PhamTheMy3089/Ardu_ECU/REFERENCES/Hardware/3D Printable Files/Bendix Sleeve.stl

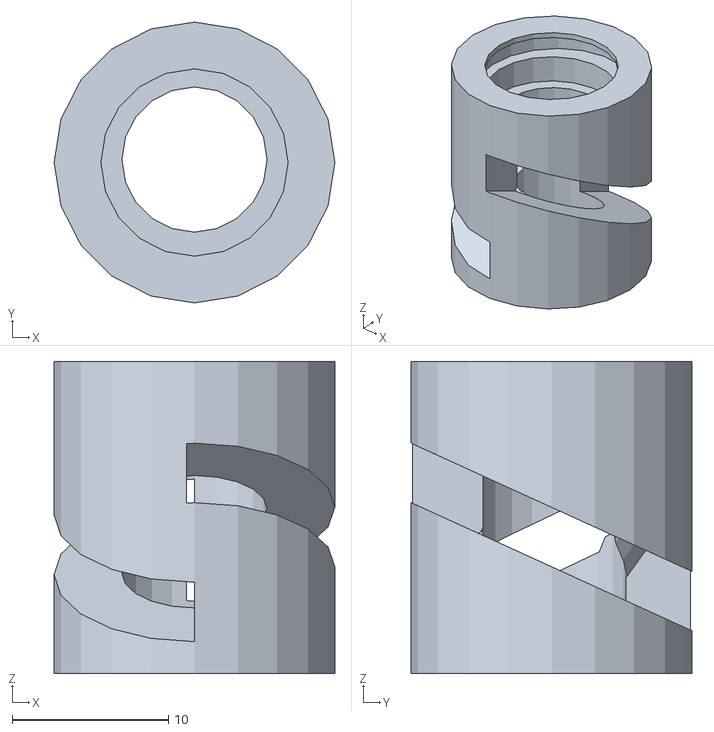
[picture p6: CAD file, 2026-07-16]
REFERENCES/Hardware/3D Printable Files/Bendix Sleeve.stl
18.0 x 18.0 x 20.0
