PhamTheMy3089/Ardu_ECU/REFERENCES/Hardware/3D Printable Files/Brushless motor mount.stl

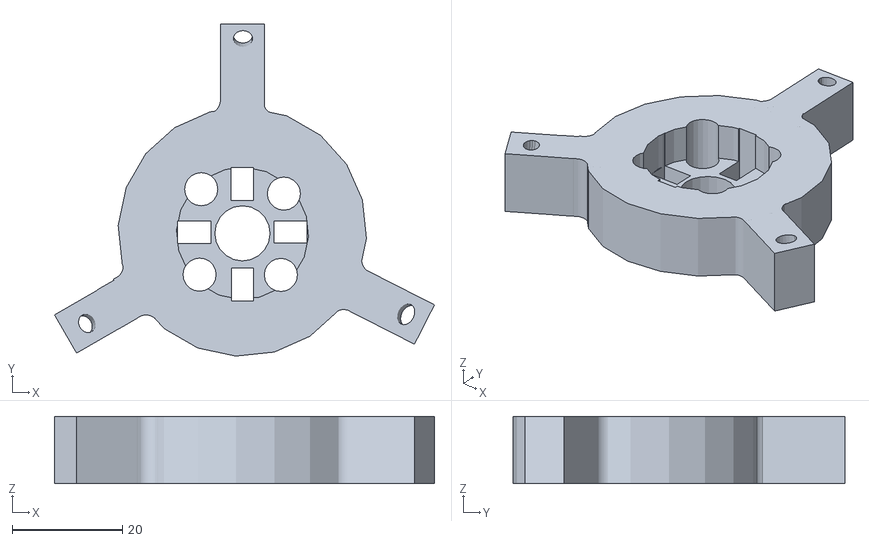
[picture p7: CAD file, 2026-07-16]
REFERENCES/Hardware/3D Printable Files/Brushless motor mount.stl
68.9 x 60.2 x 12.2
