PhamTheMy3089/Ardu_ECU/PROJECT_CURRENT/Docs/BringUp_Logs/RPM_TEST_STARTER_log_20260719.txt

# Log bench-test cảm biến RPM bằng firmware TEST_STARTER (2026-07-19)
#
# Bối cảnh: chạy sau khi đã sửa lỗi D1 (TVS clamp sai kẹp GPIO33 xuống ~2V).
# Rotor được thổi quay bằng gió (starter chưa kéo tải thật), tốc độ rất chậm.
# Quét PWM 1000 -> 1220us, ppr=1, filter=120us, edge=RISING, step=10us.
#
# Kết luận đọc log:
#  - Xung RPM ĐÃ tới GPIO33 (raw=1..5/cửa sổ 100ms) -> sửa D1 thành công.
#  - RPM ghim ~1500 và NOISE nhảy CLEAN<->NOISY, cv/jit vọt cao là artifact
#    lượng tử hóa ở tốc độ quay rất thấp (chỉ ~3 xung/cửa sổ), KHÔNG phải lỗi.
#  - REST_GUARD đúng: khi OFF và PWM thấp -> RPM=0 / NO_SIGNAL.
#  - Sau STARTER OFF, RPM=1500 treo vài cửa sổ do rotor quay trớn -> bình thường.
# ------------------------------------------------------------------------------

TEST_STARTER booted. Starter DISARMED at 1000us (khong quay).
Dung '+' / '-' de tang/giam PWM. Go 'help' de xem menu.
Web UI: SSID=TEST_STARTER PASS=test1234 URL=http://192.168.4.1

==== TEST_STARTER: RPM vs PWM noise/stability ====
  +           tang PWM starter 1 buoc
  -           giam PWM starter 1 buoc
  0 / s       dung starter (PWM=1000us)
  step <us>   doi buoc +/- (1..200)
  pwm <us>    dat PWM truc tiep (1000..2000)
  ppr <n>     xung/vong (mac dinh 1)
  filter <us> bo loc glitch RPM (20..2000)
  edge rising|falling   canh kich RPM
  reset       xoa bo dem RPM
  status      in trang thai ngay
  help        in menu nay
  hien tai: step=10us ppr=1 filter=120us edge=RISING
==================================================

ESC armed. San sang test.
PWM=1000us(OFF) | RPM=83 (win 223) | raw=10 acc=9 rej=0 (0.0%) | jit=390.0% cv=-- | NOISE=NOISY STAB=OFF
PWM=1000us(OFF) | RPM=83 (win 0) | raw=0 acc=0 rej=0 (0.0%) | jit=0.0% cv=0.0% | NOISE=CLEAN STAB=OFF
PWM=1000us(OFF) | RPM=0 (win 0) | raw=0 acc=0 rej=0 (0.0%) | jit=0.0% cv=0.0% | NOISE=NO_SIGNAL STAB=OFF
PWM=1000us(OFF) | RPM=0 (win 0) | raw=0 acc=0 rej=0 (0.0%) | jit=0.0% cv=0.0% | NOISE=NO_SIGNAL STAB=OFF
PWM=1000us(OFF) | RPM=0 (win 0) | raw=0 acc=0 rej=0 (0.0%) | jit=0.0% cv=0.0% | NOISE=NO_SIGNAL STAB=OFF
PWM=1000us(OFF) | RPM=0 (win 0) | raw=0 acc=0 rej=0 (0.0%) | jit=0.0% cv=0.0% | NOISE=NO_SIGNAL STAB=OFF
PWM=1000us(OFF) | RPM=0 (win 0) | raw=0 acc=0 rej=0 (0.0%) | jit=0.0% cv=0.0% | NOISE=NO_SIGNAL STAB=OFF
PWM=1000us(OFF) | RPM=0 (win 0) | raw=0 acc=0 rej=0 (0.0%) | jit=0.0% cv=0.0% | NOISE=NO_SIGNAL STAB=OFF
PWM=1010us (+)
PWM=1010us | RPM=0 (win 0) | raw=0 acc=0 rej=0 (0.0%) | jit=0.0% cv=-- | NOISE=NO_SIGNAL STAB=SETTLING
PWM=1010us | RPM=0 (win 0) | raw=0 acc=0 rej=0 (0.0%) | jit=0.0% cv=-- | NOISE=NO_SIGNAL STAB=SETTLING
PWM=1020us (+)
PWM=1020us | RPM=0 (win 0) | raw=0 acc=0 rej=0 (0.0%) | jit=0.0% cv=-- | NOISE=NO_SIGNAL STAB=SETTLING
PWM=1030us (+)
PWM=1030us | RPM=0 (win 0) | raw=0 acc=0 rej=0 (0.0%) | jit=0.0% cv=-- | NOISE=NO_SIGNAL STAB=SETTLING
PWM=1040us (+)
PWM=1040us | RPM=0 (win 0) | raw=0 acc=0 rej=0 (0.0%) | jit=0.0% cv=-- | NOISE=NO_SIGNAL STAB=SETTLING
PWM=1050us (+)
PWM=1050us | RPM=0 (win 0) | raw=0 acc=0 rej=0 (0.0%) | jit=0.0% cv=-- | NOISE=NO_SIGNAL STAB=SETTLING
PWM=1060us (+)
PWM=1060us | RPM=0 (win 0) | raw=0 acc=0 rej=0 (0.0%) | jit=0.0% cv=-- | NOISE=NO_SIGNAL STAB=SETTLING
PWM=1060us | RPM=0 (win 0) | raw=0 acc=0 rej=0 (0.0%) | jit=0.0% cv=-- | NOISE=NO_SIGNAL STAB=SETTLING
PWM=1070us (+)
PWM=1070us | RPM=0 (win 0) | raw=0 acc=0 rej=0 (0.0%) | jit=0.0% cv=-- | NOISE=NO_SIGNAL STAB=SETTLING
PWM=1080us (+)
PWM=1080us | RPM=0 (win 0) | raw=0 acc=0 rej=0 (0.0%) | jit=0.0% cv=-- | NOISE=NO_SIGNAL STAB=SETTLING
PWM=1090us (+)
PWM=1090us | RPM=0 (win 0) | raw=0 acc=0 rej=0 (0.0%) | jit=0.0% cv=-- | NOISE=NO_SIGNAL STAB=SETTLING
PWM=1090us | RPM=0 (win 0) | raw=0 acc=0 rej=0 (0.0%) | jit=0.0% cv=-- | NOISE=NO_SIGNAL STAB=SETTLING
PWM=1100us (+)
PWM=1100us | RPM=0 (win 0) | raw=0 acc=0 rej=0 (0.0%) | jit=0.0% cv=-- | NOISE=NO_SIGNAL STAB=SETTLING
PWM=1110us (+)
PWM=1110us | RPM=0 (win 0) | raw=0 acc=0 rej=0 (0.0%) | jit=0.0% cv=-- | NOISE=NO_SIGNAL STAB=SETTLING
PWM=1110us | RPM=0 (win 0) | raw=0 acc=0 rej=0 (0.0%) | jit=0.0% cv=-- | NOISE=NO_SIGNAL STAB=SETTLING
PWM=1120us (+)
PWM=1120us | RPM=0 (win 0) | raw=0 acc=0 rej=0 (0.0%) | jit=0.0% cv=-- | NOISE=NO_SIGNAL STAB=SETTLING
PWM=1130us (+)
PWM=1130us | RPM=0 (win 0) | raw=0 acc=0 rej=0 (0.0%) | jit=0.0% cv=-- | NOISE=NO_SIGNAL STAB=SETTLING
PWM=1140us (+)
PWM=1140us | RPM=0 (win 0) | raw=0 acc=0 rej=0 (0.0%) | jit=0.0% cv=-- | NOISE=NO_SIGNAL STAB=SETTLING
PWM=1140us | RPM=0 (win 0) | raw=0 acc=0 rej=0 (0.0%) | jit=0.0% cv=-- | NOISE=NO_SIGNAL STAB=SETTLING
PWM=1140us | RPM=0 (win 0) | raw=0 acc=0 rej=0 (0.0%) | jit=0.0% cv=-- | NOISE=NO_SIGNAL STAB=SETTLING
PWM=1140us | RPM=0 (win 0) | raw=0 acc=0 rej=0 (0.0%) | jit=0.0% cv=-- | NOISE=NO_SIGNAL STAB=NO_SIGNAL
PWM=1140us | RPM=0 (win 0) | raw=0 acc=0 rej=0 (0.0%) | jit=0.0% cv=-- | NOISE=NO_SIGNAL STAB=NO_SIGNAL
PWM=1150us (+)
PWM=1150us | RPM=4 (win 0) | raw=0 acc=0 rej=0 (0.0%) | jit=0.0% cv=-- | NOISE=CLEAN STAB=SETTLING
PWM=1150us | RPM=100 (win 0) | raw=0 acc=0 rej=0 (0.0%) | jit=0.0% cv=139.0% | NOISE=CLEAN STAB=SETTLING
PWM=1160us (+)
PWM=1160us | RPM=250 (win 500) | raw=1 acc=1 rej=0 (0.0%) | jit=0.0% cv=39.1% | NOISE=CLEAN STAB=SETTLING
PWM=1160us | RPM=500 (win 500) | raw=1 acc=1 rej=0 (0.0%) | jit=0.0% cv=51.2% | NOISE=CLEAN STAB=SETTLING
PWM=1160us | RPM=500 (win 500) | raw=1 acc=1 rej=0 (0.0%) | jit=0.0% cv=46.9% | NOISE=CLEAN STAB=SETTLING
PWM=1160us | RPM=500 (win 500) | raw=1 acc=1 rej=0 (0.0%) | jit=0.0% cv=38.6% | NOISE=CLEAN STAB=UNSTABLE
PWM=1170us (+)
PWM=1170us | RPM=750 (win 750) | raw=2 acc=2 rej=0 (0.0%) | jit=40.0% cv=-- | NOISE=WARN STAB=SETTLING
PWM=1170us | RPM=750 (win 1000) | raw=2 acc=2 rej=0 (0.0%) | jit=0.0% cv=14.3% | NOISE=CLEAN STAB=SETTLING
PWM=1170us | RPM=1500 (win 1000) | raw=2 acc=2 rej=0 (0.0%) | jit=66.7% cv=37.8% | NOISE=NOISY STAB=SETTLING
PWM=1170us | RPM=1479 (win 1000) | raw=2 acc=2 rej=0 (0.0%) | jit=65.4% cv=37.7% | NOISE=NOISY STAB=UNSTABLE
PWM=1170us | RPM=750 (win 1000) | raw=2 acc=2 rej=0 (0.0%) | jit=0.0% cv=34.4% | NOISE=CLEAN STAB=UNSTABLE
PWM=1180us (+)
PWM=1180us | RPM=1500 (win 1500) | raw=3 acc=3 rej=0 (0.0%) | jit=0.0% cv=34.6% | NOISE=CLEAN STAB=SETTLING
PWM=1180us | RPM=1500 (win 1000) | raw=2 acc=2 rej=0 (0.0%) | jit=66.7% cv=28.3% | NOISE=NOISY STAB=SETTLING
PWM=1190us (+)
PWM=1190us | RPM=1500 (win 1500) | raw=3 acc=3 rej=0 (0.0%) | jit=0.0% cv=-- | NOISE=CLEAN STAB=SETTLING
PWM=1190us | RPM=1500 (win 1500) | raw=3 acc=3 rej=0 (0.0%) | jit=0.0% cv=0.0% | NOISE=CLEAN STAB=SETTLING
PWM=1190us | RPM=1500 (win 1500) | raw=3 acc=3 rej=0 (0.0%) | jit=0.0% cv=0.0% | NOISE=CLEAN STAB=SETTLING
PWM=1200us (+)
PWM=1200us | RPM=1500 (win 1500) | raw=3 acc=3 rej=0 (0.0%) | jit=0.0% cv=-- | NOISE=CLEAN STAB=SETTLING
PWM=1200us | RPM=1500 (win 1500) | raw=3 acc=3 rej=0 (0.0%) | jit=0.0% cv=0.0% | NOISE=CLEAN STAB=SETTLING
PWM=1200us | RPM=1500 (win 1500) | raw=3 acc=3 rej=0 (0.0%) | jit=0.0% cv=0.0% | NOISE=CLEAN STAB=SETTLING
PWM=1200us | RPM=1500 (win 1500) | raw=3 acc=3 rej=0 (0.0%) | jit=0.0% cv=0.0% | NOISE=CLEAN STAB=STABLE
PWM=1200us | RPM=1500 (win 2000) | raw=4 acc=4 rej=0 (0.0%) | jit=131.7% cv=0.0% | NOISE=NOISY STAB=STABLE
PWM=1210us (+)
PWM=1210us | RPM=1500 (win 1875) | raw=5 acc=5 rej=0 (0.0%) | jit=124.1% cv=-- | NOISE=NOISY STAB=SETTLING
PWM=1210us | RPM=1500 (win 1500) | raw=3 acc=3 rej=0 (0.0%) | jit=0.0% cv=0.0% | NOISE=CLEAN STAB=SETTLING
PWM=1210us | RPM=1500 (win 1500) | raw=3 acc=3 rej=0 (0.0%) | jit=0.0% cv=0.3% | NOISE=CLEAN STAB=SETTLING
PWM=1210us | RPM=94488 (win 2000) | raw=4 acc=4 rej=0 (0.0%) | jit=130.5% cv=294.0% | NOISE=NOISY STAB=UNSTABLE
PWM=1210us | RPM=1500 (win 1500) | raw=3 acc=3 rej=0 (0.0%) | jit=0.0% cv=307.8% | NOISE=CLEAN STAB=UNSTABLE
PWM=1210us | RPM=1500 (win 1500) | raw=3 acc=3 rej=0 (0.0%) | jit=0.0% cv=307.8% | NOISE=CLEAN STAB=UNSTABLE
PWM=1210us | RPM=1500 (win 1500) | raw=3 acc=3 rej=0 (0.0%) | jit=0.0% cv=307.8% | NOISE=CLEAN STAB=UNSTABLE
PWM=1220us (+)
PWM=1220us | RPM=1500 (win 1500) | raw=3 acc=3 rej=0 (0.0%) | jit=0.0% cv=-- | NOISE=CLEAN STAB=SETTLING
PWM=1220us | RPM=1500 (win 1500) | raw=3 acc=3 rej=0 (0.0%) | jit=0.0% cv=0.0% | NOISE=CLEAN STAB=SETTLING
PWM=1220us | RPM=1500 (win 1500) | raw=3 acc=3 rej=0 (0.0%) | jit=0.0% cv=0.0% | NOISE=CLEAN STAB=SETTLING
PWM=1220us | RPM=1500 (win 1500) | raw=3 acc=3 rej=0 (0.0%) | jit=0.0% cv=0.0% | NOISE=CLEAN STAB=STABLE
PWM=1220us | RPM=1500 (win 1500) | raw=3 acc=3 rej=0 (0.0%) | jit=0.0% cv=0.0% | NOISE=CLEAN STAB=STABLE
PWM=1220us | RPM=1500 (win 2000) | raw=4 acc=4 rej=0 (0.0%) | jit=131.9% cv=0.0% | NOISE=NOISY STAB=STABLE
STARTER OFF (PWM=1000us).
PWM=1000us(OFF) | RPM=1500 (win 1500) | raw=3 acc=3 rej=0 (0.0%) | jit=0.0% cv=0.0% | NOISE=CLEAN STAB=OFF
PWM=1000us(OFF) | RPM=1500 (win 1500) | raw=3 acc=3 rej=0 (0.0%) | jit=0.0% cv=0.0% | NOISE=CLEAN STAB=OFF
PWM=1000us(OFF) | RPM=1500 (win 1500) | raw=3 acc=3 rej=0 (0.0%) | jit=0.0% cv=0.0% | NOISE=CLEAN STAB=OFF
PWM=1000us(OFF) | RPM=1500 (win 1500) | raw=3 acc=3 rej=0 (0.0%) | jit=1.4% cv=315.1% | NOISE=CLEAN STAB=OFF
PWM=1000us(OFF) | RPM=1500 (win 1500) | raw=3 acc=3 rej=0 (0.0%) | jit=0.0% cv=315.1% | NOISE=CLEAN STAB=OFF
