PhamTheMy3089/Ardu_ECU/(list of files, drawings)

Other design files:
PROJECT_CURRENT/Hardware/SCH_MinijetengineECU_20260723.json
