PhamTheMy3089/Ardu_ECU/(commit log)

2026-07-16 Add reference folder with system documentation and current state files
    - Create "Tham khảo" (Reference) folder
    - Add RPM_Sensor_20260709.net - RPM sensor schematic
    - Add ECU_TestV1_EGT_DRY_START_PATCH.ino - Test firmware version
    - Add SCH_MinijetengineECU_20260709.json - ECU design schema
    Claude-Session: https://claude.ai/code/session_01CcruVnyNiUwatgB1FCaWjr
    [SCH_MinijetengineECU_20260709.json]
2026-07-16 Reorganize project structure for better organization and maintainability
    Changes:
    - Create Documentation/ folder for guides and manuals
    * Documentation/Manuals/ for all user guides
    - Create Hardware/ folder for all hardware-related files
    * Hardware/Schematics/ - Circuit diagrams and reference schemas
    * Hardware/Components/ - Component images and references
    * Hardware/3D Printable Files/ - 3D models for printing
    - Create Firmware/ folder with version-based organization
    * Firmware/Rev9/, Rev10/ - Archived versions
    * Firmware/Rev11/ - Current stable release
    * Firmware/Rev12_TC10/ - Test version
    * Firmware/TestV1_EGT_DRY_START/ - Latest development
    - Eliminate duplicate firmware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
    [Bendix Sleeve.stl, Brushed motor mount.stl, Brushless motor mount.stl, SCH_MinijetengineECU_20260709.json]
2026-07-16 Add comprehensive project review and assessment
    - Analysis of project structure, organization, and file arrangement
    - Firmware version comparison (Rev11, Rev12_TC10, TestV1_EGT_DRY_START)
    - Code quality assessment with strengths and issues
    - Documentation completeness review
    - 10 key recommendations with priorities
    - Security and performance analysis
    - Improvement checklist for future development
    - Overall project scoring (7.5/10 - Grade B+)
    Focus areas for improvement:
    - Add hardware assembly and pinout documentation
    - Create component BOM with suppliers
    - Add comprehensive code comments
    - Implement CI/CD pipeline
    - Create testing procedures
    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
2026-07-16 Reorganize project structure: separate CURRENT project from REFERENCES
    Major Changes:
    - Create PROJECT_CURRENT/ folder for active project (3 files)
    * ECU_TestV1_EGT_DRY_START_PATCH.ino (main firmware)
    * RPM_Sensor_20260709.net (RPM sensor schematic)
    * SCH_MinijetengineECU_20260709.json (ECU design schema)
    - Move all reference materials to REFERENCES/ folder
    * REFERENCES/Firmware/ (Rev9, Rev10, Rev11, Rev12_TC10, TestV1)
    * REFERENCES/Hardware/ (schematics, 3D models, components)
    * REFERENCES/Documentation/ (old manuals and guides)
    Documentation:
    - Add PROJECT_CURRENT/README.md (current project guide)
    - Add REFERENCES/README.md (reference materials guide)
    - Update main README.md (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
    [Bendix Sleeve.stl, Brushed motor mount.stl, Brushless motor mount.stl, SCH_MinijetengineECU_20260709.json]
2026-07-16 Add comprehensive firmware code architecture guide
    - Detailed explanation of state machine design
    - Configuration structure and parameters
    - EGT, RPM, and fuel control systems
    - Pin assignments and connections
    - Start sequence flow
    - Web UI and SD logging systems
    - Test Wizard/Checklist integration
    - Safety features and abort mechanisms
    - Debugging tips and learning path
    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
2026-07-16 Add comprehensive firmware upload and testing guide
    Content includes:
    - Hardware requirements checklist
    - Arduino IDE setup (Board Manager, Libraries)
    - ESP32 board configuration
    - Pin connections and wiring diagram
    - Step-by-step firmware upload process
    - Serial Monitor testing (115200 baud)
    - Web UI access and testing (ECU_TestV1 / admin1234)
    - Detailed test procedures:
    * Power & Serial communication
    * Status LED behavior
    * EGT sensor reading & validation
    * RPM sensor signal quality
    * Button input testing
    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
2026-07-16 Add code review findings, pre-engine test guide, and reference documents
    - CODE_REVIEW_FINDINGS.md: Full firmware review (8 findings: 2 HIGH, 3 MEDIUM, 3 LOW)
    - HIGH: stage2Off() missing EGT guard for Web UI path
    - HIGH: ABORTED restart requires no fault acknowledgment
    - MEDIUM: First RPM pulse after resetRpmStats() bypasses glitch filter
    - MEDIUM: stale egt.gradientCps displayed when sensor invalid
    - MEDIUM: Serial readStringUntil can block loop up to 1s
    - PRE_ENGINE_TEST_GUIDE.md: Step-by-step noise check and test procedure
    - Phase 0: Physical inspection checklist
    - Phase 1: First boot verification
    - Phase 2: RPM noise characterization (REST_GUARD, EMI from glow/starter)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
2026-07-16 Fix all 8 code review findings in ECU firmware
    Bug fixes applied to ECU_TestV1_EGT_DRY_START_PATCH.ino:
    HIGH:
    - Fix #1: stage2Off() now blocks transition to WAITING when in ABORTED
    mode and EGT is still hot (was missing EGT guard for Serial/Web UI path)
    - Fix #2: Restart from ABORTED now requires explicit clearabort command;
    abortAcknowledged flag is reset on every abortAll() and must be set
    before arm2/startidle; physical button sets flag automatically
    MEDIUM:
    - Fix #3: RPM ISR no longer counts first pulse after resetRpmStats() as
    accepted — records timestamp only, preventing EMI spike at start of
    wet ST_SPINUP_PREHEAT from masking starter failure
    - Fix #3b: resetRpmStats() is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
    [ECU_TestV1_EGT_DRY_START_PATCH.ino]
2026-07-16 Add TEST/TEST_STARTER bench firmware for RPM vs starter PWM testing
    Standalone test sketch to characterize the RPM sensor and starter before
    running the real engine. No ARM, no protection interlocks — focused purely
    on RPM noise and stability measurement per PWM level.
    Behavior:
    - On boot, starter stays disarmed at 1000us (does not spin)
    - '+' / '-' keys step starter PWM up/down (default 10us step, adjustable)
    - ESP32 continuously measures RPM and reports two verdicts:
    * NOISE: CLEAN / WARN / NOISY / NO_SIGNAL (from rejectPct + jitter)
    * STAB: STABLE / WARN / UNSTABLE / SETTLING / OFF (from RPM CV% once PWM settles)
    - Reuses the same glitch filter and ISR logic as the main ECU firmwa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
    [TEST_STARTER.ino]
2026-07-16 Add DSO152 RPM sensor calibration guide for KMZ10A circuit
    Documents the full 5-step oscilloscope procedure to calibrate the
    KMZ10A AMR magnetoresistive sensor circuit using DSO152:
    - Maps all 10 testpoints (U1/U2/U3/U12-U16/U21/GPIO33) to signal stages
    - Explains 3 trimpots: RP1=offset, RP2=gain, RP3=comparator threshold
    - Step-by-step DSO152 settings (coupling, volt/div, time/div, trigger)
    for each stage: power rail → INA826 out → LMV358 → comparator out
    - Includes RP3 margin procedure (find dropout point, back off 1/4 turn)
    - EMI test with starter ESC to verify threshold holds under noise
    - Final verification via TEST_STARTER.ino: NOISE=CLEAN, rejectPct<5%
    - Calibration log templ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
2026-07-16 Reorganize PROJECT_CURRENT into Firmware/Hardware/Docs subfolders
    Split mixed flat directory into 3 purpose-specific subfolders:
    Firmware/ECU_TestV1_EGT_DRY_START_PATCH/
    └── ECU_TestV1_EGT_DRY_START_PATCH.ino (Arduino IDE requires folder = sketch name)
    Hardware/
    ├── RPM_Sensor_20260709.net
    └── SCH_MinijetengineECU_20260709.json
    Docs/
    ├── CODE_ARCHITECTURE.md
    ├── CODE_REVIEW_FINDINGS.md
    ├── UPLOAD_AND_TEST_GUIDE.md
    ├── PRE_ENGINE_TEST_GUIDE.md
    └── DSO152_RPM_CALIBRATION_GUIDE.md
    Update README.md to reflect new structure with reading-order table.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
    [SCH_MinijetengineECU_20260709.json]
2026-07-16 Update root README to reflect reorganized project structure
    - Cập nhật cây thư mục: PROJECT_CURRENT/Firmware|Hardware|Docs, TEST/, REFERENCES/
    - Bổ sung pinout đầy đủ, danh sách tính năng firmware, signal chain KMZ10A
    - Thêm bảng TEST/ firmware và REFERENCES/ contents
    - Liên kết đến DSO152_RPM_CALIBRATION_GUIDE.md
    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
2026-07-16 Fix 9 code review findings (round 2) in ECU firmware
    * Update root README to reflect reorganized project structure
    * Fix 9 code review findings (round 2) in ECU firmware
    Safety-critical:
    - pumptest/test pump now blocked when EGT readable & hot (no fuel into hot engine)
    - RPM_SIGNAL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
    [ECU_TestV1_EGT_DRY_START_PATCH.ino]
2026-07-16 Add step-by-step commissioning guide (bench test to throttle-up) (#6)
    - pumptest/test pump now blocked when EGT readable & hot (no fuel into hot eng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
2026-07-16 Add comm-link watchdog and fix abort log snapshot timing (#7)
    - R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
    [ECU_TestV1_EGT_DRY_START_PATCH.ino]
2026-07-16 Valve1/Valve2 role split (EnJet manual) + Chinese reference manual (#8)
    - pumptest/test pump now blocked when EGT readable & hot (no fuel into hot e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
    [ECU_TestV1_EGT_DRY_START_PATCH.ino]
2026-07-16 Clean up stale root docs and dangling reference links (#9)
    - RPM_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
2026-07-16 Fix remaining round-1 findings: SD slot overflow and jitter metric (#10)
    - pumptest/test pump now blocked when EGT readable & hot (no fuel into hot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
    [ECU_TestV1_EGT_DRY_START_PATCH.ino]
2026-07-16 Add EnJet E80/E100 reference manual and residual-fuel drain step (#11)
    - pumptest/test pump now blocked when EGT readable & hot (no fuel into hot en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
2026-07-17 Consolidate all test/commissioning docs into one guide file (#12)
    - pumptest/test pump now blocked when EGT readable & hot (no fuel into hot engine)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
2026-07-17 Expand RP1/RP2/RP3 explanations and fix DSO152 trigger modes (#13)
    - pumptest/test pump now blocked when EGT readable & hot (no fuel into hot engine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
2026-07-17 Replace ESP32Servo with LEDC, add starter kick, add Web UI to TEST_STARTER (#14)
    - pumptest/test pump now blocked when EGT readable & hot (no fuel i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
    [ECU_TestV1_EGT_DRY_START_PATCH.ino, TEST_STARTER.ino]
2026-07-18 Fix Arduino compile error: forward-declare state enums (#15)
    The LEDC switch added escAttach()/escWriteUs() as the first functions in
    the sketch, ahead of the enum definitions. The Arduino IDE injects its
    auto-generated function prototypes right before the first function, so
    prototypes like modeName(EcuMode) landed before EcuMode was declared,
    failing with "'EcuMode' was not declared in this scope" (and a cascade of
    "redeclared as different kind of entity"). Plain g++ didn't catch this
    because it doesn't inject prototypes.
    Forward-declare EcuMode/StartStage/RpmNoiseLevel/TestId/TestResult near
    the top (legal opaque declarations thanks to their fixed underlying type)
    so the injected prototyp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
    [ECU_TestV1_EGT_DRY_START_PATCH.ino]
2026-07-18 DSO152 guide fixes + remove starter kick + bump starter/pump test values (#16)
    * Docs: clarify DSO152 probe points per step + fix magnet-distance guidance
    Each DSO152 calibration step (A1-A5, A-final) now opens with an explicit
    "Nối probe" callout naming the exact testpoint for the signal probe (U16/
    U14/U3/U1/U2/GPIO33) and its physical location on the RPM sensor board,
    plus the GND clip point (U15). Added a probe-convention block and a
    single-channel reminder at the top of Stage A.
    Accuracy fixes to match this build's real geometry: the neodymium magnet
    is fixed ~5cm from the KMZ10A inside an aluminium wheel and cannot be
    moved (aluminium does not shield the field, so amplitude is stil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
    [ECU_TestV1_EGT_DRY_START_PATCH.ino, TEST_STARTER.ino]
2026-07-18 Safety fixes from full-project review (HIGH/MEDIUM/LOW) (#17)
    State machine / interlocks:
    - requestStop() now no-ops unless STARTING/IDLING/OPERATING, so `stop` from
    ABORTED can no longer wipe the abort reason, re-spin the starter, or leak
    ABORTED->WAITING past the clearabort interlock.
    - stage2Off()/`off` from ABORTED no longer clears the fault; it re-asserts
    safe outputs and requires an explicit clearabort.
    - Physical-button starts set runStartedByButton so the comm watchdog (which
    needs a Serial/Web link) no longer aborts a healthy engine the instant it
    reaches IDLING; the flag clears on any remote command. beginAutoIdle() also
    refreshes lastOperatorLinkMs.
    Config safety:
    - P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
    [ECU_TestV1_EGT_DRY_START_PATCH.ino]
2026-07-18 Round-2 review fixes: control-logic + docs consistency (#18)
    Control logic (verified findings from a fresh full-project sweep):
    - Over-temp soft fuel cut is now effective: when egtRequestsFuelCut() fires,
    pumpUs steps down by fuelCutStepUs at the fast decel rate (~40us/s) instead
    of the old ~2us/s ramp that could never keep up before the hard OVER_TEMP
    abort. Bounded by the hard abort as a backstop.
    - Operating governor targets maxRpm - rpmTolerance at 100% throttle so full
    throttle no longer drives the engine into its own OVERSPEED abort.
    - Faster flameout response: fueled RPM-loss in IDLING/OPERATING uses a 400ms
    window (FUELED_RPM_LOSS_TIMEOUT_MS) instead of the 1s signal timeou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
    [ECU_TestV1_EGT_DRY_START_PATCH.ino]
2026-07-18 Address remaining LOW review items (#19)
    - #17 Block igniter (ignpulse) and fuel valves (valve1/valve2 on) when EGT is
    still hot, so ABORTED-after-hot-cooldown-timeout can't re-light or open fuel
    into a hot core. Starter-only starttest stays allowed (it aids cooling).
    - #18 Log-only "EGT frozen" warning (never aborts) when the reading is unchanged
    for EGT_STUCK_WARN_MS while combusting - hints at a stuck thermocouple that the
    MAX31855 open/short fault path cannot catch. Conservative to avoid false trips.
    - #19 Coerce micros() to nonzero in both RPM ISRs so the "no edge yet" zero
    sentinel can't collide at the ~71min micros() wrap (dropped one sample).
    - #20 jsonEscape now handles \r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
    [ECU_TestV1_EGT_DRY_START_PATCH.ino, TEST_STARTER.ino]
2026-07-18 CODE_ARCHITECTURE update + round-3 &amp; gate-review fixes (#20)
    * Docs: rewrite CODE_ARCHITECTURE.md to match current firmware
    The architecture guide had drifted badly from the code (ESP32Servo, old
    1919-line/line-number references, pre-tuning fuel/RPM behaviour). Rewrote it
    to reflect the current firmware:
    - Raw LEDC PWM driver (escAttach/escWriteUs) instead of ESP32Servo, plus the
    forward-declared-enum note.
    - Accurate loop() order and the full Config field/`set`-command surface, incl.
    pumpTestUs, starterPurge/Spin/Assist, maxgrad, and the WAITING/ABORTED-only
    tuning restriction.
    - EGT dual look-aheads (3s fuel vs 0.2s abort), stuck-sensor log warning,
    dry-start; RPM two-stage d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
    [ECU_TestV1_EGT_DRY_START_PATCH.ino]
2026-07-18 Docs: fix remaining stale references found in a full doc-vs-code audit (#21)
    - Root README.md: drop ESP32Servo from the required-library list (matches
    PROJECT_CURRENT/README.md and CLAUDE.md; the firmware uses raw LEDC).
    - CODE_ARCHITECTURE.md: classifyRpmNoise NOISY threshold was raw>0, code is
    raw>1 (lone post-reset priming edge isn't noise); documented the
    stage2Off()/off COOLDOWN+cooldownAfterAbort case alongside the ABORTED one;
    noted the Test Wizard's hot-EGT guard on test ign/starter_ign/valve1/valve2;
    noted `set ppr` is WAITING/ABORTED-only.
    - COMMISSIONING_GUIDE.md: removed a near-verbatim duplicated "xả nhiên liệu
    tồn dư" subsection under Giai đoạn 6; added a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
2026-07-19 Add RPM sensor bring-up logs + EMI diagnosis (#22)
    Thêm nhật ký bring-up cảm biến RPM (TEST_STARTER run 1 & 2 + đo DSO152) và
    bài học chốt: chuỗi cảm biến hoạt động, sửa D1 thành công; RPM ghim 1500 khi
    ESC chạy nhưng đọc đúng khi ESC tắt => nhiễu EMI motor/ESC, không phải lỗi firmware.
2026-07-19 Fix docs (LM358) + TEST_STARTER RPM ISR spike bug (#23)
    Đính chính IC op-amp là LM358 (không phải LMV358) trong tài liệu, ghi chú
    trần output ~3.1-3.8V là bình thường với LM358; sửa bug ISR trong
    TEST_STARTER.ino cho phép xung giả đơn lẻ tạo RPM ảo (94k-365k) do thiếu
    sanity-check period giữa 2 xung chấp nhận.
    [TEST_STARTER.ino]
2026-07-20 Fix RPM interrupt-count ceiling + pump test noise/calibration cleanup (#25)
    * Remove redundant per-loop ledcWrite() call in RPM test sketches
    TEST_RPM_RAWCOUNT.ino va TEST_STARTER.ino goi applyPwm()/ledcWrite()
    vo dieu kien moi vong loop(), du gia tri PWM khong doi. Voi LEDC phan
    cung ESP32, sau khi ledcWrite() duoc goi 1 lan thi song PWM tu phat
    doc lap trong phan cung - khong can "refresh" lien tuc nhu comment cu
    ghi (khac ESP32Servo). setPwm() da goi applyPwm() moi khi gia tri PWM
    thuc su thay doi, nen loi goi lai moi vong loop() la thua.
    Nghi ngo day la nguyen nhan gay tran cung RAW_EDGES/s~25 quan sat duoc
    khi doi chieu voi DSO152 (Fre do van tang tuyen tinh 32/39/46/52Hz
    trong khi RA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
    [ECU_TestV1_EGT_DRY_START_PATCH.ino, TEST_RPM_RAWCOUNT.ino, TEST_STARTER.ino]
2026-07-20 Fix Test Wizard starter RPM read + uncap manual bench-test duration (#26)
    * Fix Test Wizard starter test: read RPM before stop, spin 5s
    The Test Wizard 'test starter'/'test starter_ign' steps read RPM/noise
    AFTER commanding the starter back to ESC_SAFE_US. With ecuMode==WAITING and
    startStage==ST_NONE, that instantly satisfies rpmAtRestGuardCondition(), so
    the rest-guard forces rpmData.rpm=0 / RPM_REST_NOISE - the verdict always
    read RPM=0 the moment the starter stopped.
    - Capture the RPM/noise verdict while the starter is still spinning, then stop.
    - Extend the spin window 3000->5000ms (STARTER_TEST_SPIN_MS) so the motor
    reaches a steady RPM before the final sample; 3s left it still acc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
    [ECU_TestV1_EGT_DRY_START_PATCH.ino]
2026-07-20 Web UI: full control/test/tuning parity (no terminal required) (#27)
    Every operation previously reachable only from the Serial console now has a
    button or input on the web dashboard (http://192.168.4.1), so commissioning
    can be done entirely from a phone/browser:
    Controls: add AutoStart OFF and CLEAR ABORT (with confirm); EGT start-mode
    now shows the live DRY/STRICT state.
    Manual actuator tests: add igniter/glow pulse (ignpulse <ms>), Valve 1/2
    ON/OFF (manual hold, auto-off 10s); starter/pump manual tests kept.
    Tuning: add RPM tolerance, max EGT gradient; new RPM-sensor section (PPR
    1/2, RPM glitch filter us, edge rising/falling); new collapsible Advanced
    section for accel/decel/lowaccel/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
    [ECU_TestV1_EGT_DRY_START_PATCH.ino]
2026-07-20 Web UI: SD config persistence + tabbed layout + RPM/EGT gauges (#28)
    Config persistence (configure once, auto-load on boot):
    - New saveConfigToSd()/loadConfigFromSd() write/read all tunable parameters
    as key=value lines in /ECUCFG.TXT. loadConfigFromSd() runs early in setup()
    (before attachRpmInterrupt so a persisted rpmedge/rpmfilter takes effect)
    and clamps every value to its valid range so a corrupt file can't push a
    limit out of bounds. autoStart/throttle/web are intentionally NOT persisted
    (always boots safe).
    - Refactored SD mount into an idempotent mountSd() shared by config + logging,
    so config loads even when CSV logging is disabled.
    - New Web buttons + serial commands: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
2026-07-21 RPM-gated ignition start sequence + engine/starter protection (#29)
    Rework the auto-start state machine per bench/EnJet-based spec, and add two
    always-on protection guards. All new thresholds are tunable via Web UI
    (Settings) / serial 'set' and persist to SD.
    Start sequence (SPINUP_RAMP -> IGNITE -> PREHEAT_FUEL -> ACCEL_TO_IDLE):
    - SPINUP_RAMP: starter ramps startRampFromUs->startRampToUs (1150->1300us) over
    startRampMs (30s); begins ignition once RPM > ignArmRpm (3000). Aborts
    NO_IGNITION_RPM if RPM never reaches the arm point within spinupRpmTimeoutMs.
    - IGNITE: glow ON ignOnMs (3s) / OFF ignWaitMs (3s), up to ignMaxAttempts (3);
    success when EGT reaches ignitionThresholdC (100C) -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
    [ECU_TestV1_EGT_DRY_START_PATCH.ino]
2026-07-21 Detailed light-off start sequence (2-valve) + refined engine protection (#30)
    Full start-sequence redesign per Quy_trinh_Khoi_Dong spec (added as
    PROJECT_CURRENT/Docs/QUY_TRINH_KHOI_DONG.md). Stages:
    PURGE -> SPINUP_PREHEAT -> INTRO_FUEL -> LIGHTOFF -> ACCEL_TO_IDLE.
    - PURGE: starter ramps from 1150us at +1us/rampStepMs (250ms -> 4us/s) until
    RPM>ignArmRpm(3000), dwell purgeTimeMs, then preheat. No fuel/glow.
    - SPINUP_PREHEAT: glow ON preheatMs (stays on).
    - INTRO_FUEL: pump at introFuelUs (min ~1015us) + open Start Valve (valve1).
    - LIGHTOFF (2-valve sequencing): wait fuelDelayMs; confirm REAL light-off =
    EGT>=100C AND dEGT/dt>=lightOffMinRiseCps held lightOffConfirmMs (guards
    agains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
    [ECU_TestV1_EGT_DRY_START_PATCH.ino]
2026-07-21 Web UI: fix garbled Vietnamese text (missing UTF-8 charset) (#31)
    The page has no charset declared anywhere - neither <meta charset> in the
    HTML nor a charset on the HTTP Content-Type header - so browsers guessed the
    encoding for the Vietnamese diacritics embedded in the page (mojibake).
    - Add <meta charset="utf-8"> as the first tag in <head>.
    - Serve '/' with Content-Type 'text/html; charset=utf-8' instead of bare
    'text/html'. (The /api JSON response is unaffected: RFC 8259 mandates
    UTF-8 for application/json, so it already renders correctly.)
    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
    [ECU_TestV1_EGT_DRY_START_PATCH.ino]
2026-07-21 Testing: remove ARM requirement, remove valve1/2 auto-off (#32)
    Per request, bench component tests no longer require arm2 first:
    - requireArmAndIdleForTest() (Test Wizard: ign/starter/starter_ign/valve1/
    valve2/pump) - dropped the isStage2Armed() check, kept WAITING/ABORTED gate.
    - ignpulse / starttest / pumptest / valve1 on / valve2 on - same.
    startidle, autostart on, and disabling the checklist/comm-watchdog
    interlocks are UNCHANGED and still require arm2 (not test commands).
    valve1/valve2 manual 'on' no longer auto-off after 10s - they stay on until
    'valve1 off'/'valve2 off' (or a safety abort/reset) is issued. Removed the
    now-dead manualValve1OffAtMs/manualValve2OffAtMs timers and
    VAL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
    [ECU_TestV1_EGT_DRY_START_PATCH.ino]
2026-07-22 Web UI Manual tab + PURGE stable-hold before ramping (dry test + real start) (#33)
    * Web UI: add Manual control tab (continuous hold, no auto-off)
    New serial/web commands, paralleling how valve1/valve2 on/off already work
    (no timer, held until explicitly turned off):
    - startmanual <us> / startmanual off -> hold starter PWM
    - pumpmanual <us> / pumpmanual off -> hold pump PWM + open Start Valve
    - ign on / ign off -> hold glow plug
    All gated WAITING/ABORTED-only; pumpmanual/ign on respect the existing
    hot-EGT block (fuelCommandBlockedByHotEgt()). These clear the corresponding
    manual*OffAtMs auto-off timer so a lingering starttest/pumptest/ignpulse
    window can't override t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
2026-07-23 Hardware schematic update + Manual tab PWM range/status/step (#34)
    * Hardware: update ECU schematic + netlist (glow plug now via relay)
    Replaces the 2026-07-09 schematic/netlist with the 2026-07-23 versions.
    IGN_CTRL connector is now labeled "To module 5V relay" documenting the
    glow-plug driver change from MOSFET board to opto relay module; the
    electrical interface (GND/5V/PWM with 220R series + 10K pulldown) is
    unchanged, so no other schematic/netlist edits were needed. Reviewed:
    all GPIO pin assignments still match firmware, RPM sensor front-end and
    testpoints still match DSO152_RPM_CALIBRATION_GUIDE.
    Claude-Session: https://claude.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
    [SCH_MinijetengineECU_20260709.json, SCH_MinijetengineECU_20260723.json]
2026-07-23 Manual tab: pump/glow refinements + AUTO START sequence (#35)
    * Manual tab: pump nudge buttons step 1us instead of 10us
    Starter nudge stays at 10us/press; pump is a finer-tuned fuel PWM so
    +/- now moves 1us/press to match.
    * Manual tab: auto-off glow when EGT stays hot + only one valve open at a time
    - Add manualGlowOffHoldMs (default 5000ms): while glow is held ON manually
    (WAITING/ABORTED) and EGT stays >= ignitionThresholdC continuously for
    this long, force glow off. Persisted to SD, exposed in Web UI Manual tab
    and Settings help, new `set manglowoffms`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
2026-07-23 Add Serial↔Web bridge (WiFi-independent control/dashboard) (#36)
    and Settings help, new `set manglowo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
2026-07-23 Move UI fully to SerialWebBridge; add wire/WiFi modes, terminal, VN tooltips (#37)
    Firmware: remove the built-in web dashboard (htmlPage() + ~23KB embedded
    HTML deleted); "/" now returns a short plain-text pointer. ESP32 keeps
    only the SoftAP JSON API (/api, /cmd) and the Serial apijson command.
    SerialWebBridge is now the sole UI, with two startup connection modes:
    - wire: Serial/USB-TTL; background reader routes JSON status to /api and
    all other lines (boot/brownout logs, command replies) to a terminal
    ring buffer.
    - wifi: proxies /api and /cmd over HTTP to the ECU SoftAP; terminal shows
    the ECU Event Log.
    New /term?since=N endpoint for incremental terminal lines, in both the
    Python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
    [ECU_TestV1_EGT_DRY_START_PATCH.ino, serial_web_bridge.py]
2026-07-23 Bridge: live connection status, Reconnect button, disconnect warning
    Wire mode's connState was a static "opened port at startup" message that
    never changed even if the ECU stopped responding entirely (unplugged,
    crashed, brownout) - the header always looked connected. A watchdog now
    derives real liveness from how recently a serial line was actually
    received: OK while fresh, "MAT KET NOI - khong phan hoi Ns" once stale
    (>2s), tracked in both the Python and Go bridges.
    Adds a "Ket noi lai" (Reconnect) button/endpoint for both modes: wire
    closes and reopens the saved COM port (recovers from unplug/replug or a
    brownout without restarting the bridge); wifi resets state so the
    poller re-probes im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
    [serial_web_bridge.py]
2026-07-23 Bridge: live connection status, Reconnect button, disconnect warning (#38)
    poller re-pro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
    [serial_web_bridge.py]
2026-07-23 Add comprehensive DSO152 RPM sensor calibration guide
    Create detailed 6-step procedure for tuning KMZ10A RPM sensor circuit:
    - Bước 1: Power supply validation (5V, 2.5V VREF)
    - Bước 2: INA826 output observation (analog signal strength)
    - Bước 3: RP1 offset calibration (center waveform at 2.5V)
    - Bước 4: RP2 gain adjustment (1–2Vpp amplitude target)
    - Bước 5: RP3 threshold tuning (clean RPM pulses, no double-pulse)
    - Bước 6: GPIO33 verification (3.3V safe input)
    Includes oscilloscope settings, testpoint reference table, troubleshooting
    matrix, and firmware verification with TEST_STARTER.ino.
    Claude-Session: https:/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
2026-07-24 Add comprehensive jet engine ECU design reference guide
    Document key subsystems for Enjet E86 control:
    - Motor starter (ESC tuning + PWM ramping algorithm)
    - RPM sensor (KMZ10A AMR + signal chain)
    - EGT temperature sensor (MAX6675/MAX31855 thermocouple)
    - Fuel pump control (brushed motor + solenoid valves)
    - Complete start sequence flowchart (5 phases: glow, spinup, ignition, rampup, sustained)
    - Safety checks (fail-to-ignite, over-temperature, over-rpm)
    - Optional hardware improvements (low-pass filter for RPM, twisted-pair cabling)
    - Pseudocode for start sequence state machine
    Includes fuel mapping logic, solenoid timing, and closed-loop EGT control
    targets (750–820°C optimal zone).
    C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
2026-07-24 Add detailed starter motor implementation guide
    Complete step-by-step procedure for fixing reset issue at ~1465us:
    Hardware section:
    - Power isolation (separate supplies for ESC vs microcontroller)
    - Buffer capacitor (1000µF/25V) across ESC power input
    - CH340 connection for firmware flashing
    ESC configuration (BLHeliSuite):
    - Startup Power: 0.125–0.25 (vs default 0.5–1.0)
    - Motor Timing: High (vs Medium)
    - Low RPM Power Protect: Disabled (vs Enabled)
    Firmware implementation:
    - Ramping algorithm (increase throttle gradually, not jump)
    - Two code versions: Arduino Servo library + ESP32 LEDC native
    - Test procedure starting from safe PWM values
    Detailed troubleshooting matrix for comm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
